itsmesid44/psychic-happiness/Robot arm.SLDASM

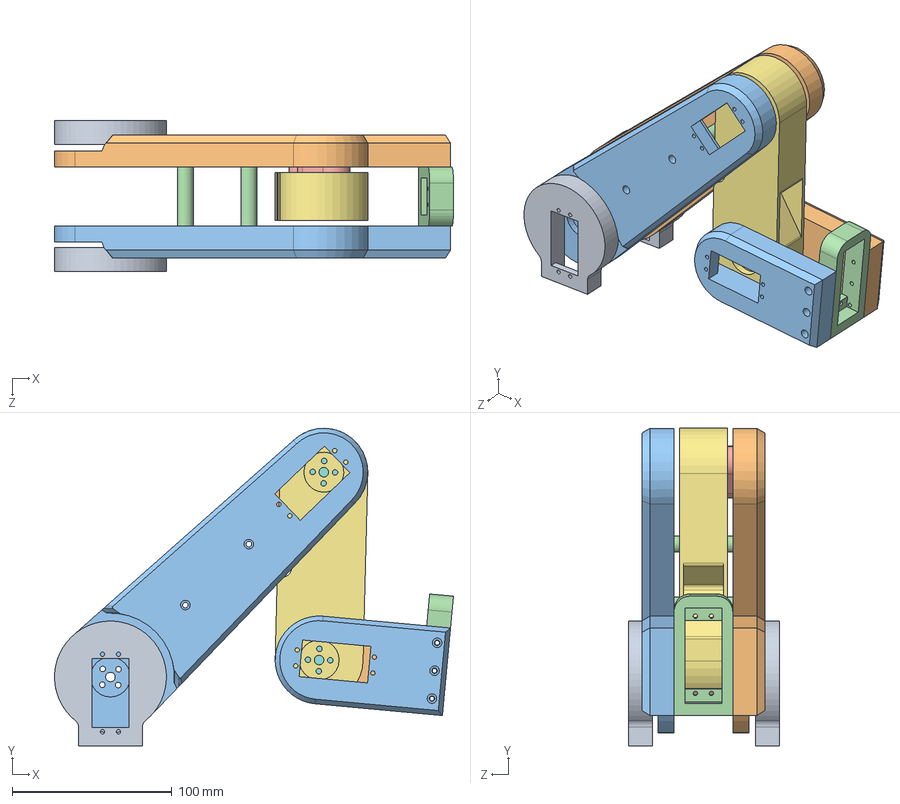
[picture p1: CAD file, 2026-04-13]
Robot arm.SLDASM
249.5 x 198.6 x 94.3 mm
Base servo mount x 2
Lower arm left
Lower arm right
Lower arm bushing x 2
Bearing holder x 2
radial ball bearing_68_iso x 2
Center arm
Center arm bearing guide x 2
Center arm bearing guide clamp x 2
Upper arm left
Upper arm right
Upper arm servo mount
