itsmesid44/psychic-happiness/Center arm.SLDPRT

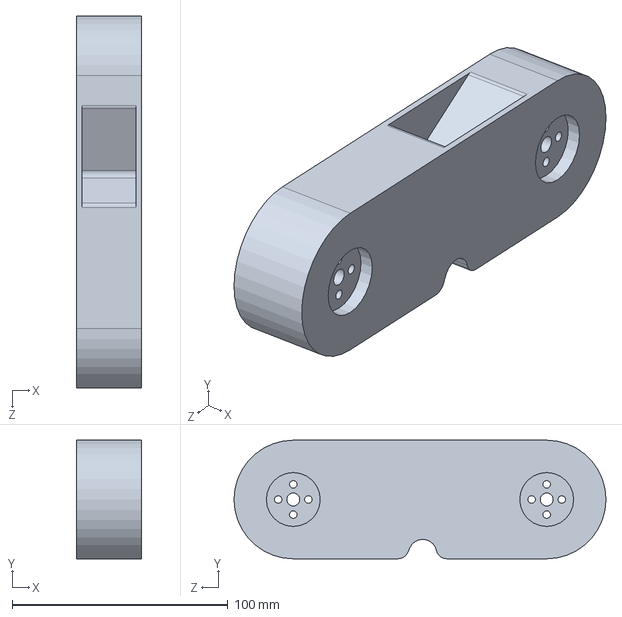
[picture p2: CAD file, 2026-04-13]
Center arm.SLDPRT
30.0 x 55.0 x 172.5 mm
