itsmesid44/psychic-happiness/Center arm bearing guide clamp.SLDPRT

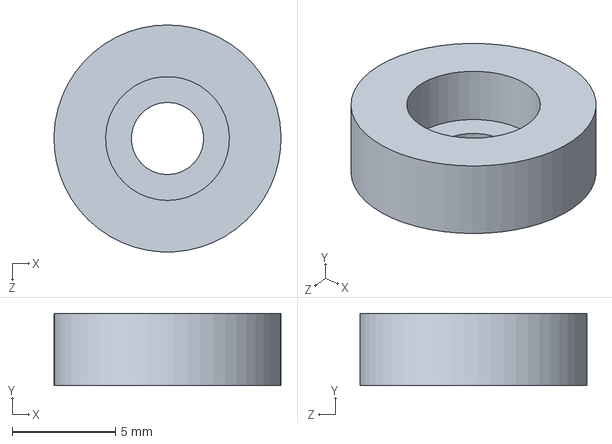
[picture p3: CAD file, 2026-04-13]
Center arm bearing guide clamp.SLDPRT
11.0 x 3.50 x 11.0 mm
