itsmesid44/psychic-happiness/Upper arm left.SLDPRT

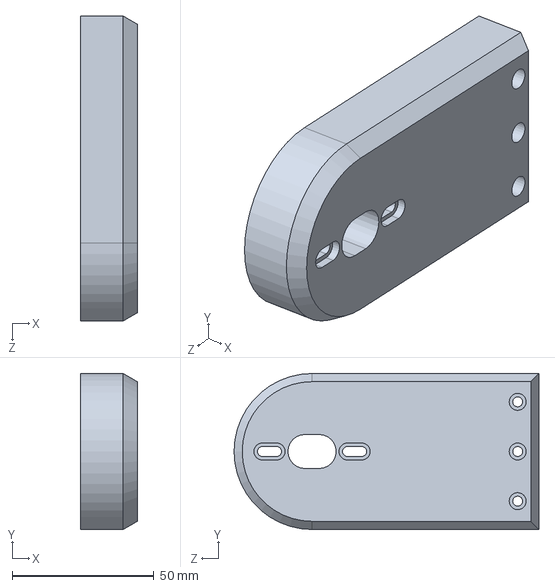
[picture p4: CAD file, 2026-04-13]
Upper arm left.SLDPRT
20.0 x 55.0 x 107.5 mm
