itsmesid44/psychic-happiness/Center arm bearing guide.SLDPRT

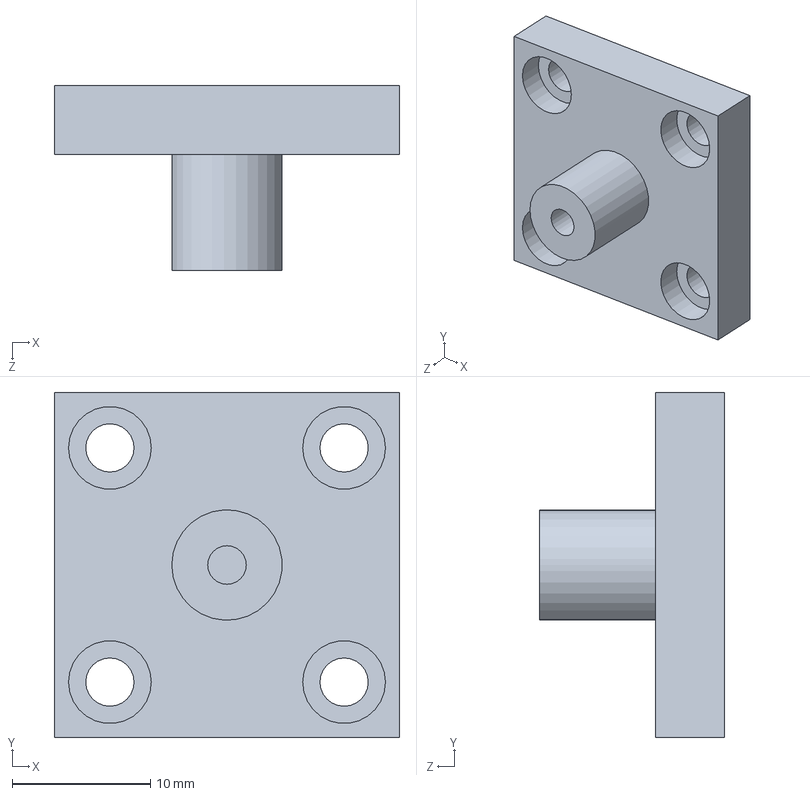
[picture p5: CAD file, 2026-04-13]
Center arm bearing guide.SLDPRT
25.0 x 25.0 x 13.4 mm
