itsmesid44/psychic-happiness/Lower arm bushing.SLDPRT

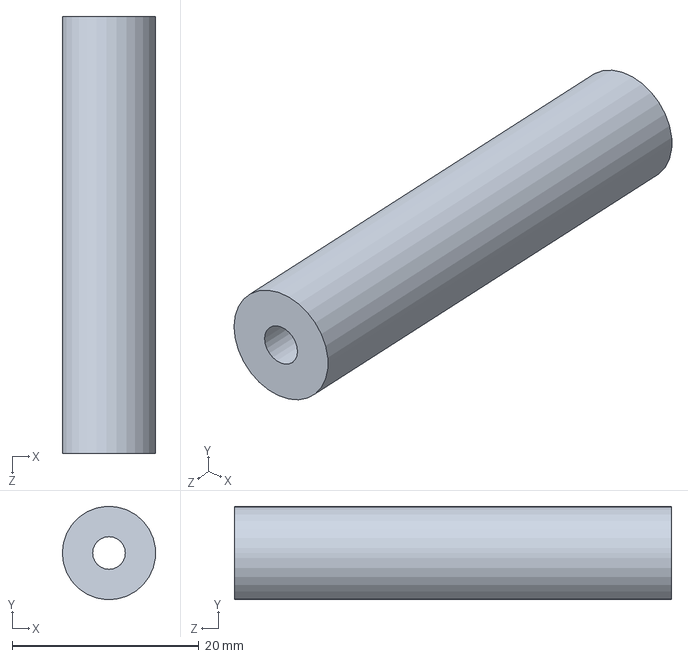
[picture p6: CAD file, 2026-04-13]
Lower arm bushing.SLDPRT
10.0 x 9.99 x 46.8 mm
