itsmesid44/psychic-happiness/Lower arm left.SLDPRT

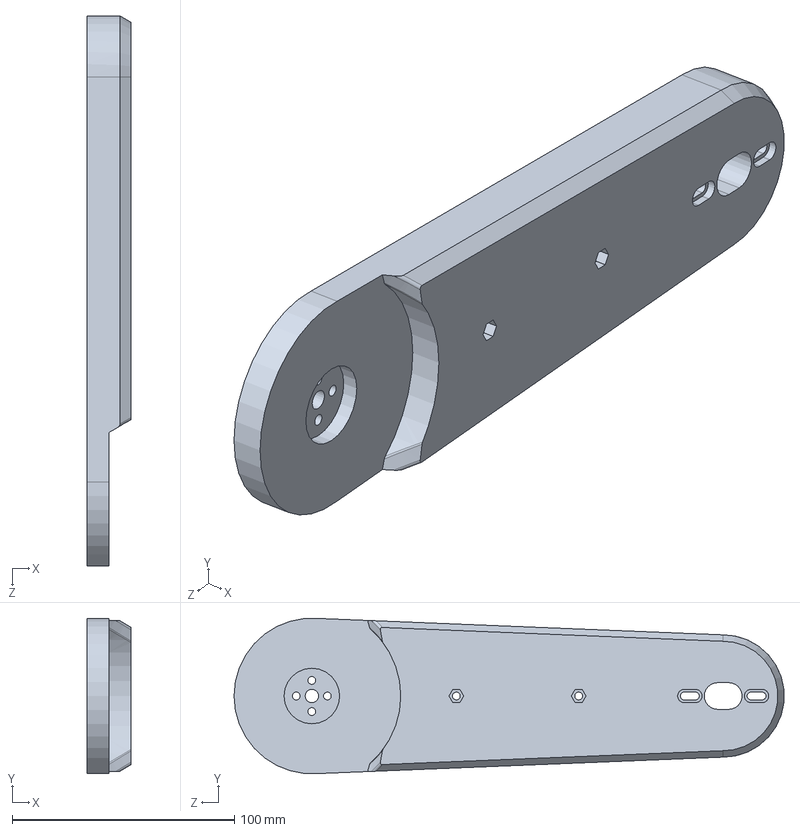
[picture p7: CAD file, 2026-04-13]
Lower arm left.SLDPRT
20.0 x 69.8 x 247.3 mm
