itsmesid44/psychic-happiness/Upper arm servo mount.SLDPRT

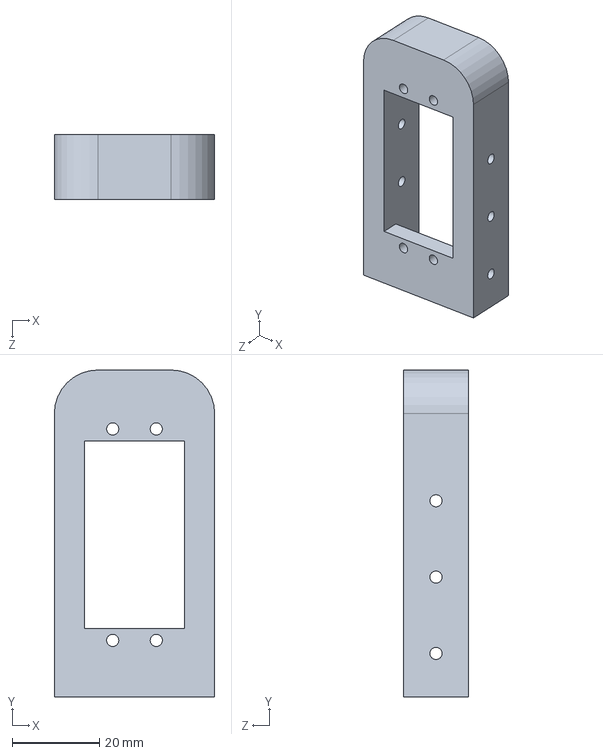
[picture p8: CAD file, 2026-04-13]
Upper arm servo mount.SLDPRT
36.8 x 75.0 x 15.0 mm
