itsmesid44/psychic-happiness/Base servo mount.SLDPRT

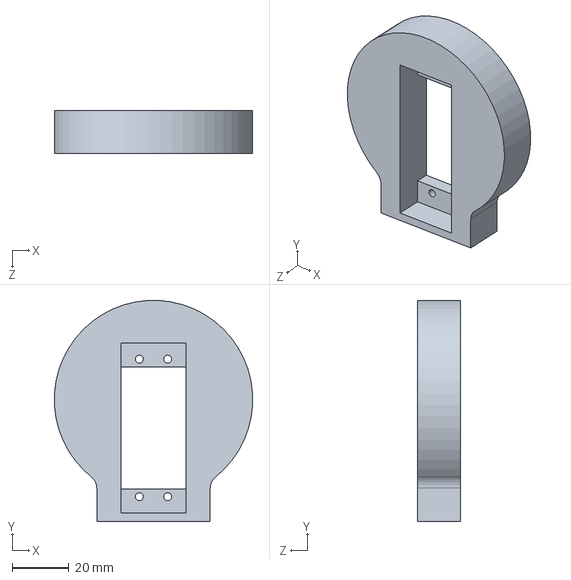
[picture p9: CAD file, 2026-04-13]
Base servo mount.SLDPRT
69.9 x 77.9 x 15.0 mm
