itsmesid44/psychic-happiness/Bearing holder.SLDPRT

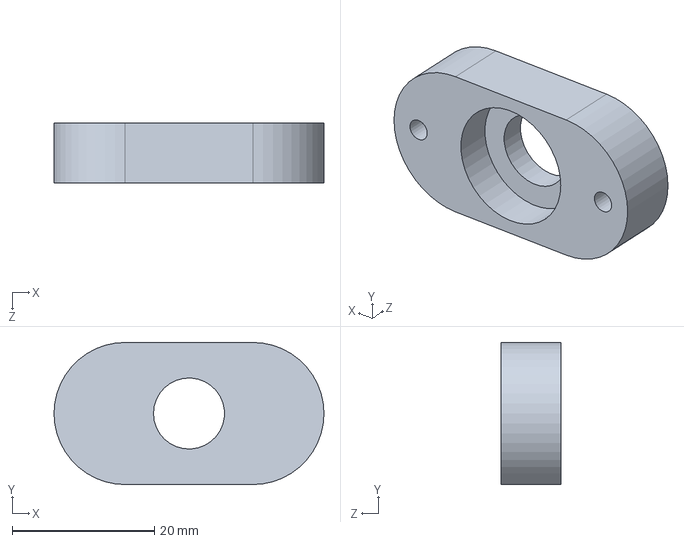
[picture p10: CAD file, 2026-04-13]
Bearing holder.SLDPRT
38.0 x 20.0 x 8.40 mm
