itsmesid44/psychic-happiness/Lower arm right.SLDPRT

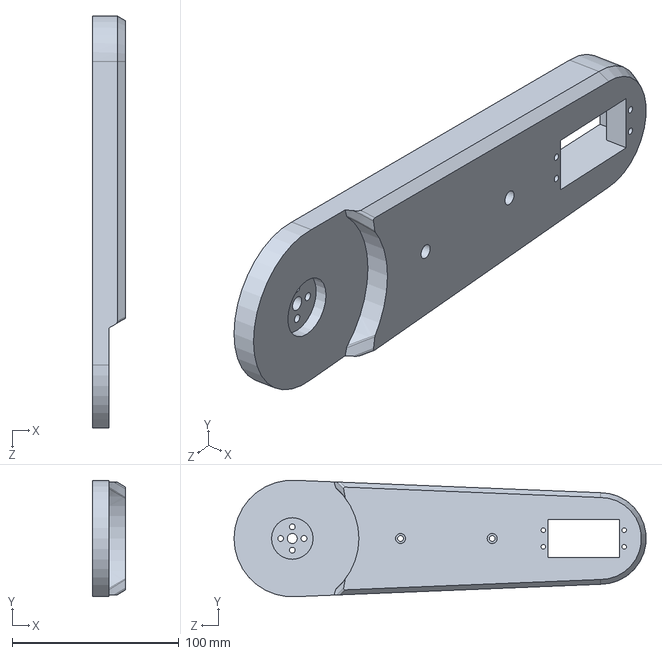
[picture p11: CAD file, 2026-04-13]
Lower arm right.SLDPRT
20.0 x 69.8 x 247.3 mm
