itsmesid44/psychic-happiness/(list of files, cad)

Other CAD files:
Upper arm right.SLDPRT
