itsmesid44/psychic-happiness/(list of files, drawings)

Other design files:
PCB_PCB_skibidi67_2026-04-13.json
PCB_PCB_wr34r234r234r2rarm_2026-04-13.json
