itsmesid44/psychic-happiness/(commit log)

2026-04-13 feat: iterative robotic arm
    [Base servo mount.SLDPRT, Bearing holder.SLDPRT, Center arm bearing guide clamp.SLDPRT, Center arm bearing guide.SLDPRT, Center arm.SLDPRT, Lower arm bushing.SLDPRT, Lower arm left.SLDPRT, Lower arm right.SLDPRT]
2026-04-13 final change hopefully
    [PCB_PCB_skibidi67_2026-04-13.json, PCB_PCB_wr34r234r234r2rarm_2026-04-13.json]
2026-04-14 egdg
    egergeg
    [Robotic Arm-bom.csv]
